atom-dispencer/SolenoidEngine4/pcb/SolenoidEngine4.kicad_pcb

## KiCad design pcb/SolenoidEngine4.kicad_pcb (2026-08-16)

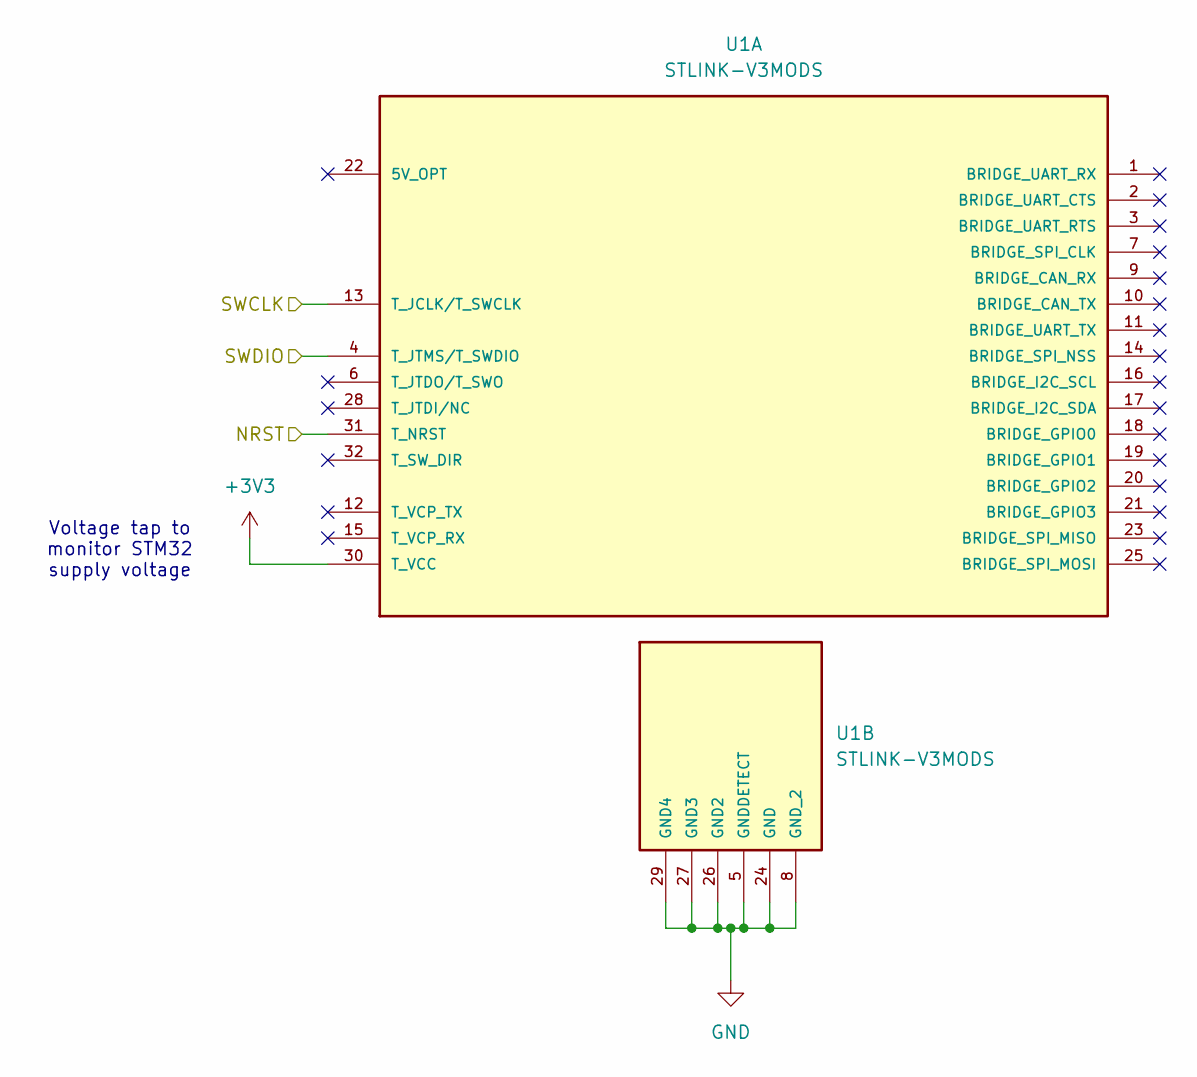
[picture p1: schematic programmer.kicad_sch]

Parts:
U1: STLINK-V3MODS; STLINK_V3MODS; PARTREV 1

Connections:
+3V3: U1.30 (T_VCC); also elsewhere on the board
/Microcontroller/NRST: U1.31 (T_NRST); also elsewhere on the board
/Microcontroller/SWCLK: U1.13 (T_JCLK/T_SWCLK); also elsewhere on the board
/Microcontroller/SWDIO: U1.4 (T_JTMS/T_SWDIO); also elsewhere on the board
GND: U1.5 (GNDDETECT), U1.8 (GND_2), U1.24 (GND), U1.26 (GND2), U1.27 (GND3), U1.29 (GND4); also elsewhere on the board

Notes on the sheet:
Voltage tap to monitor STM32 supply voltage

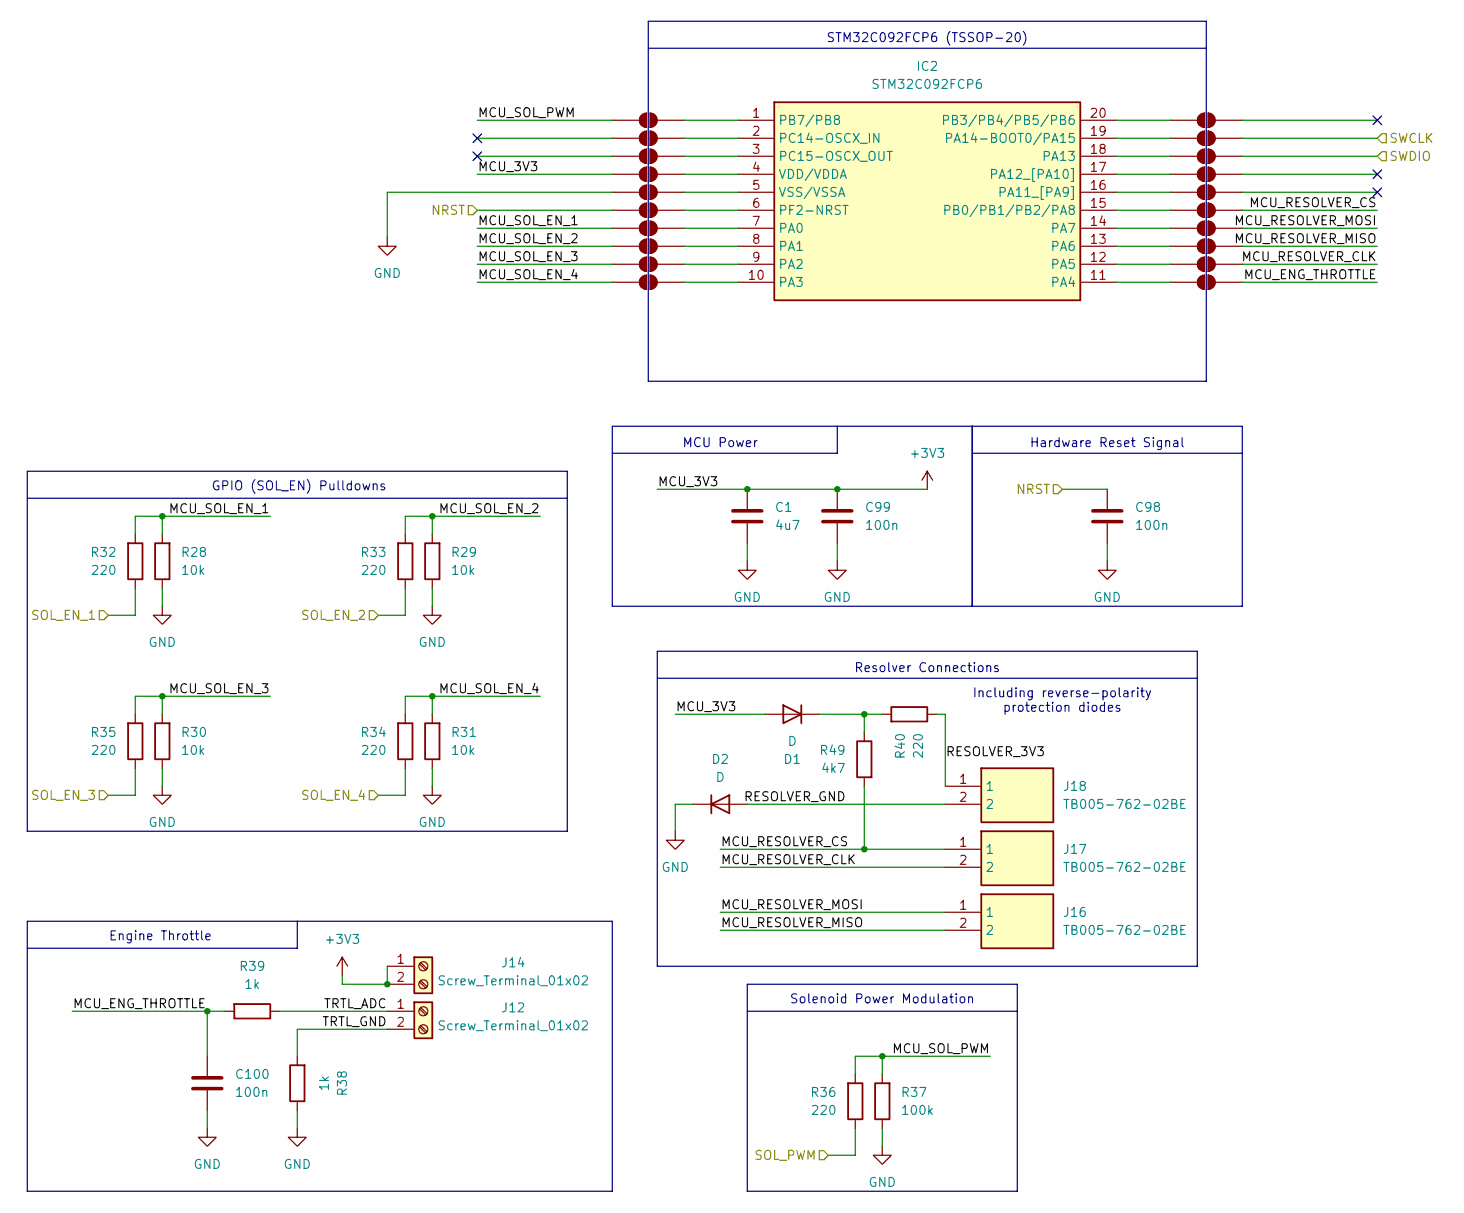
[picture p2: schematic microcontroller.kicad_sch]

Parts:
C1: 4u7; C_0805_2012Metric
C98: 100n; C_0603_1608Metric
C99, C100: 100n; C_0805_2012Metric
D1, D2: D; D_0805_2012Metric
IC2: STM32C092FCP6; SOP65P640X120-20N; Manufacturer_Part_Number STM32C092FCP6
J12, J14: Screw_Terminal_01x02; TB005-762-02BE
J16, J17, J18: TB005-762-02BE; Mouser Part Number 490-TB005-762-02BE
JP1, JP2, JP3, JP4, JP5, JP6, JP7, JP8, JP9, JP10, JP11, JP12, JP13, JP14, JP15, JP16, JP17, JP18, JP19, JP20: SolderJumper_2_Open; SolderJumper-2_P1.3mm_Open_TrianglePad1.0x1.5mm
R28, R29, R30, R31: 10k; R_0805_2012Metric
R32, R33, R34, R35, R36, R40: 220; R_0805_2012Metric
R37: 100k; R_0805_2012Metric
R38, R39: 1k; R_0805_2012Metric
R49: 4k7; R_0805_2012Metric

Connections:
+3V3: C1.1, C99.1, D1.2 (A), J14.1, J14.2, JP14.1 (A); also elsewhere on the board
/Microcontroller/MCU_ENG_THROTTLE: C100.1, JP10.2 (B), R39.2
/Microcontroller/MCU_RESOLVER_CLK: J17.2, JP9.2 (B)
/Microcontroller/MCU_RESOLVER_CS: J17.1, JP6.2 (B), R49.2
/Microcontroller/MCU_RESOLVER_MISO: J16.2, JP8.2 (B)
/Microcontroller/MCU_RESOLVER_MOSI: J16.1, JP7.2 (B)
/Microcontroller/MCU_SOL_EN_1: JP17.1 (A), R28.2, R32.2
/Microcontroller/MCU_SOL_EN_2: JP18.1 (A), R29.2, R33.2
/Microcontroller/MCU_SOL_EN_3: JP19.1 (A), R30.2, R35.2
/Microcontroller/MCU_SOL_EN_4: JP20.1 (A), R31.2, R34.2
/Microcontroller/MCU_SOL_PWM: JP11.1 (A), R36.2, R37.2
/Microcontroller/NRST: C98.1, JP16.1 (A); also elsewhere on the board
/Microcontroller/RESOLVER_3V3: J18.1, R40.1
/Microcontroller/RESOLVER_GND: D2.2 (A), J18.2
/Microcontroller/SOL_EN_1: R32.1; also elsewhere on the board
/Microcontroller/SOL_EN_2: R33.1; also elsewhere on the board
/Microcontroller/SOL_EN_3: R35.1; also elsewhere on the board
/Microcontroller/SOL_EN_4: R34.1; also elsewhere on the board
/Microcontroller/SOL_PWM: R36.1; also elsewhere on the board
/Microcontroller/SWCLK: JP2.2 (B); also elsewhere on the board
/Microcontroller/SWDIO: JP3.2 (B); also elsewhere on the board
/Microcontroller/TRTL_ADC: J12.1, R39.1
/Microcontroller/TRTL_GND: J12.2, R38.2
GND: C1.2, C98.2, C99.2, C100.2, D2.1 (K), JP15.1 (A), R28.1, R29.1, R30.1, R31.1, R37.1, R38.1; also elsewhere on the board
unnamed: D1.1 (K), R40.2, R49.1
unnamed: IC2.7 (PA0), JP17.2 (B)
unnamed: IC2.8 (PA1), JP18.2 (B)
unnamed: IC2.9 (PA2), JP19.2 (B)
unnamed: IC2.10 (PA3), JP20.2 (B)
unnamed: IC2.11 (PA4), JP10.1 (A)
unnamed: IC2.12 (PA5), JP9.1 (A)
unnamed: IC2.13 (PA6), JP8.1 (A)
unnamed: IC2.14 (PA7), JP7.1 (A)
unnamed: IC2.16 (PA11_[PA9]), JP5.1 (A_1)
unnamed: IC2.17 (PA12_[PA10]), JP4.1 (A_1)
unnamed: IC2.18 (PA13), JP3.1 (A)
unnamed: IC2.19 (PA14-BOOT0/PA15), JP2.1 (A)
unnamed: IC2.15 (PB0/PB1/PB2/PA8), JP6.1 (A)
unnamed: IC2.20 (PB3/PB4/PB5/PB6), JP1.1 (A_1)
unnamed: IC2.1 (PB7/PB8), JP11.2 (B)
unnamed: IC2.2 (PC14-OSCX_IN), JP12.2 (B_2)
unnamed: IC2.3 (PC15-OSCX_OUT), JP13.2 (B_2)
unnamed: IC2.6 (PF2-NRST), JP16.2 (B)
unnamed: IC2.4 (VDD/VDDA), JP14.2 (B)
unnamed: IC2.5 (VSS/VSSA), JP15.2 (B)

Notes on the sheet:
Solenoid Power Modulation
STM32C092FCP6 (TSSOP-20)
Hardware Reset Signal
Including reverse-polarity protection diodes
Engine Throttle
MCU Power
GPIO (SOL_EN) Pulldowns
Resolver Connections

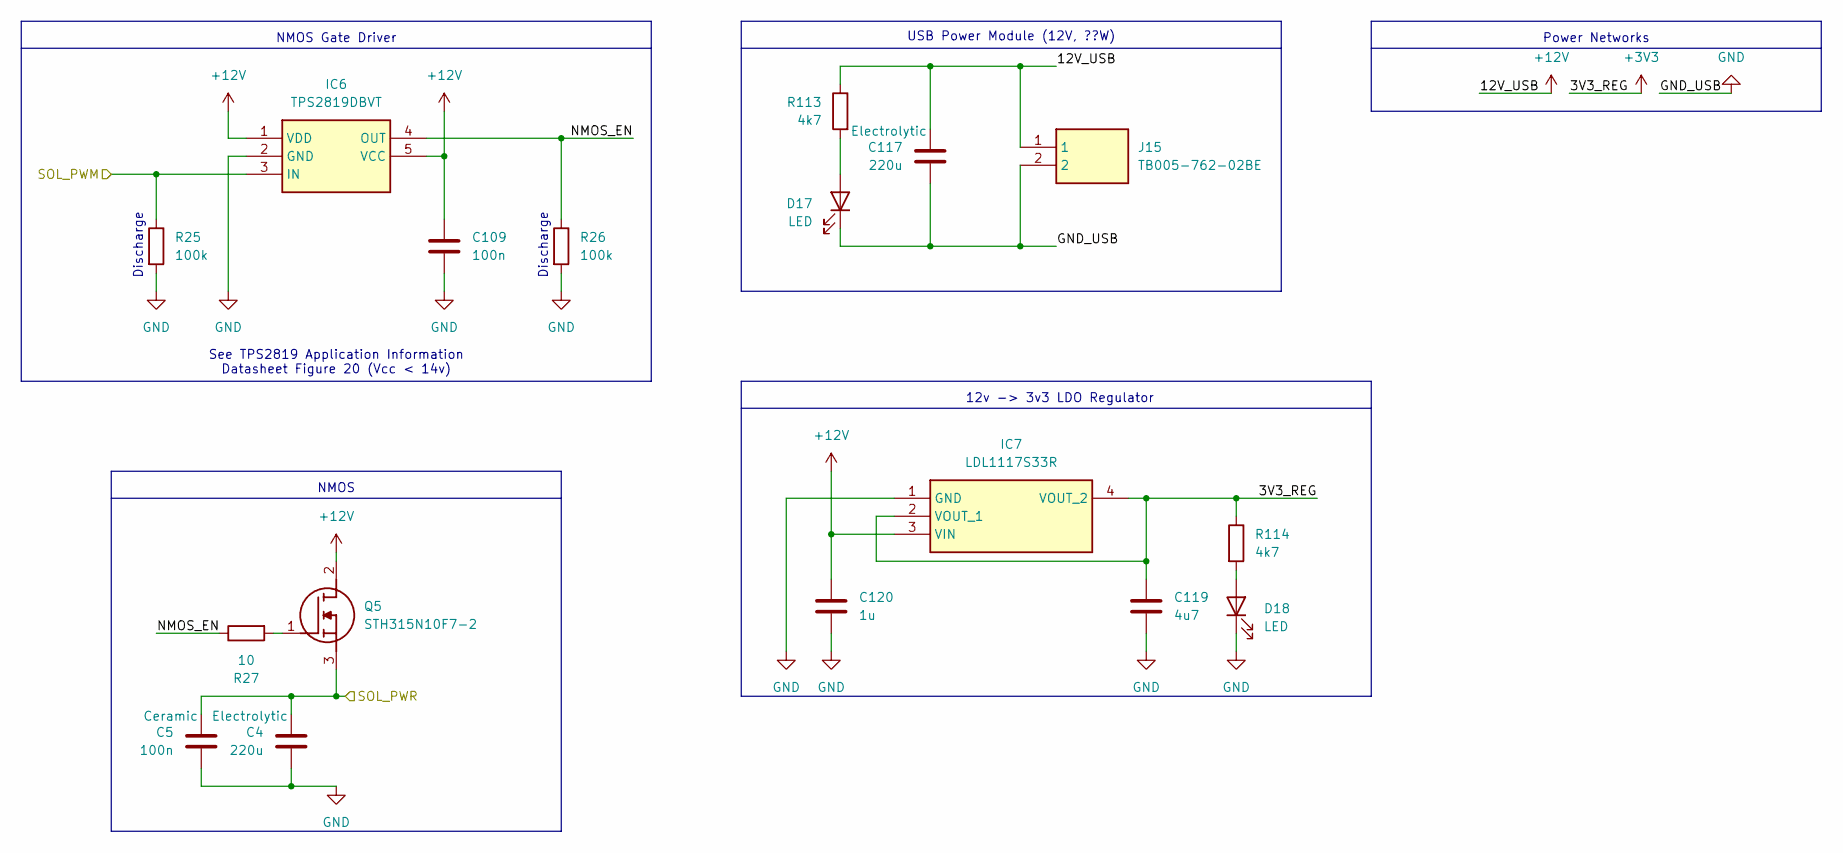
[picture p3: schematic power.kicad_sch]

Parts:
C4, C117: 220u; CP_Elec_10x10
C5, C109: 100n; C_0805_2012Metric
C119: 4u7; C_0805_2012Metric
C120: 1u; C_0805_2012Metric
D17, D18: LED; D_0805_2012Metric
IC6: TPS2819DBVT; SOT95P280X145-5N; Mouser Part Number 595-TPS2819DBVT
IC7: LDL1117S33R; SOT230P700X180-4N; Mouser Part Number 511-LDL1117S33R
J15: TB005-762-02BE; Mouser Part Number 490-TB005-762-02BE
Q5: STH315N10F7-2; STH315N10F72; Mouser Part Number 511-STH315N10F7-2
R25, R26: 100k; R_0805_2012Metric
R27: 10; R_0805_2012Metric
R113, R114: 4k7; R_0805_2012Metric

Connections:
+3V3: C119.1, IC7.2 (VOUT_1), IC7.4 (VOUT_2), R114.1; also elsewhere on the board
+12V: C109.1, C117.1, C120.1, IC6.1 (VDD), IC6.5 (VCC), IC7.3 (VIN), J15.1, Q5.2 (D), R113.1; also elsewhere on the board
/Microcontroller/SOL_PWM: IC6.3 (IN), R25.1; also elsewhere on the board
/Power/NMOS_EN: IC6.4 (OUT), R26.1, R27.1
/Solenoids/Solenoid 1/SOL+: C4.1, C5.1, Q5.3 (S); also elsewhere on the board
GND: C4.2, C5.2, C109.2, C117.2, C119.2, C120.2, D17.1 (K), D18.1 (K), IC6.2 (GND), IC7.1 (GND), J15.2, R25.2, R26.2; also elsewhere on the board
unnamed: D17.2 (A), R113.2
unnamed: D18.2 (A), R114.2
unnamed: Q5.1 (G), R27.2

Notes on the sheet:
Power Networks
USB Power Module (12V, ??W)
12v -> 3v3 LDO Regulator
See TPS2819 Application Information Datasheet Figure 20 (Vcc < 14v)
Discharge
NMOS
NMOS Gate Driver

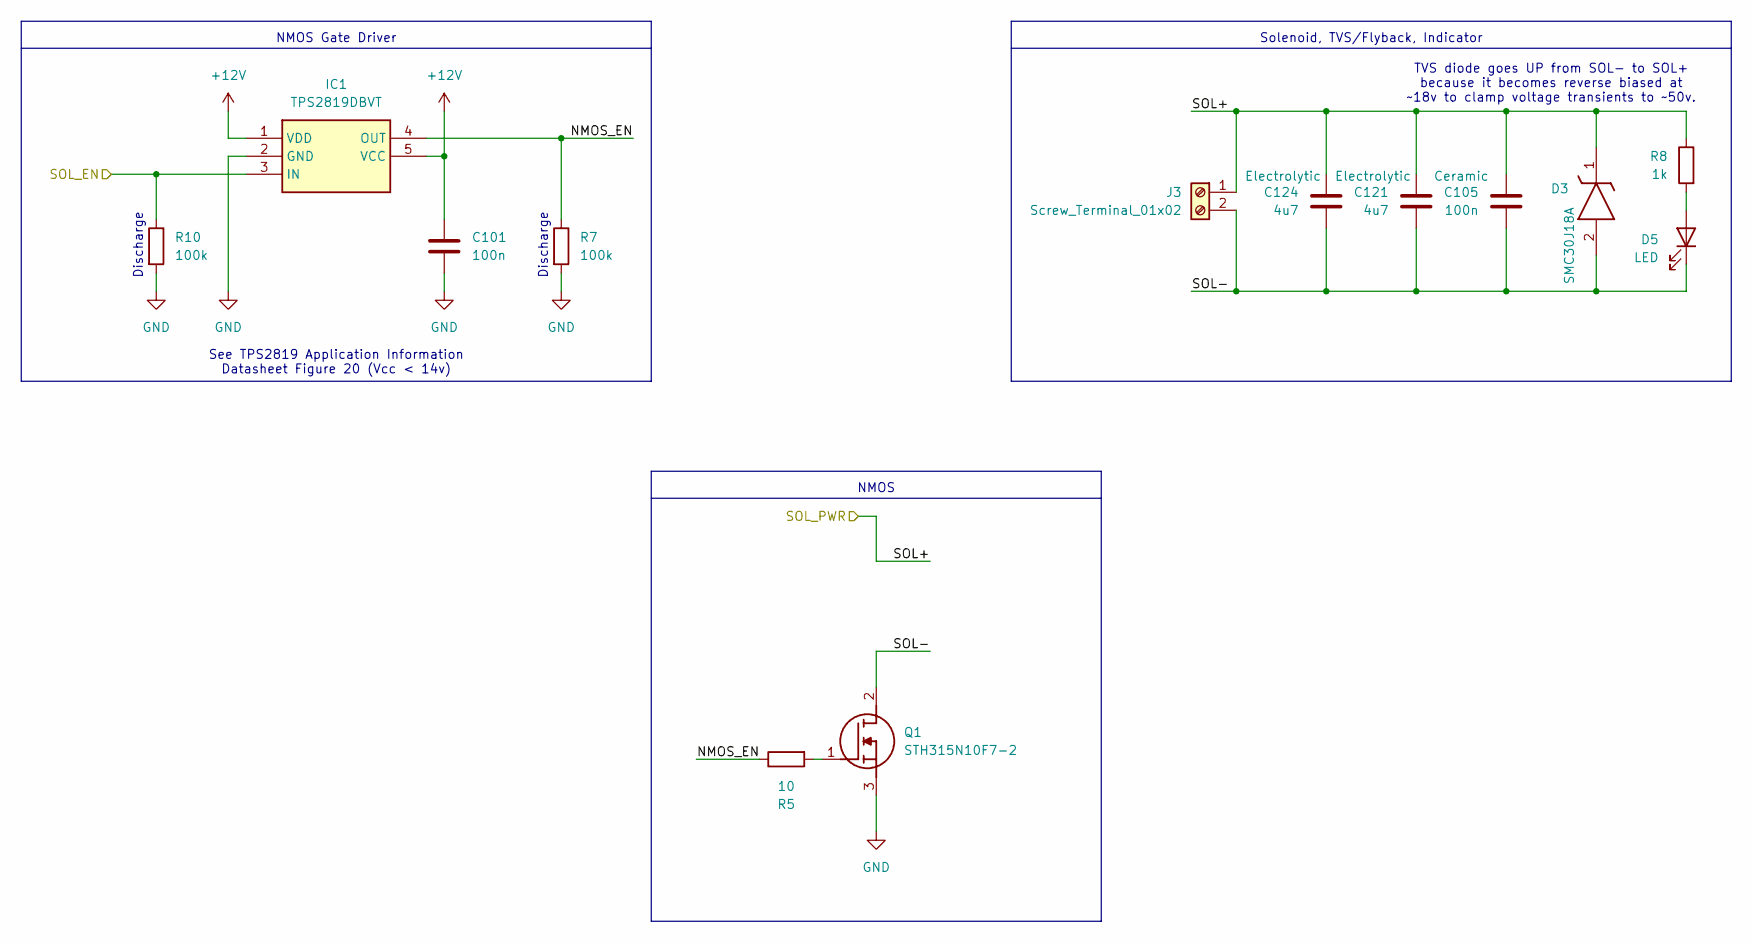
[picture p4: schematic solenoid_1.kicad_sch]

Parts:
C101, C105: 100n; C_0805_2012Metric
C121, C124: 4u7; C_0805_2012Metric
D3: SMC30J18A; DIOM8059X265N; Manufacturer_Part_Number SMC30J18A
D5: LED; D_0805_2012Metric
IC1: TPS2819DBVT; SOT95P280X145-5N; Mouser Part Number 595-TPS2819DBVT
J3: Screw_Terminal_01x02; TB005-762-02BE
Q1: STH315N10F7-2; STH315N10F72; Mouser Part Number 511-STH315N10F7-2
R5: 10; R_0805_2012Metric
R7, R10: 100k; R_0805_2012Metric
R8: 1k; R_0805_2012Metric

Connections:
+12V: C101.1, IC1.1 (VDD), IC1.5 (VCC); also elsewhere on the board
/Microcontroller/SOL_EN_1: IC1.3 (IN), R10.1; also elsewhere on the board
/Solenoids/Solenoid 1/NMOS_EN: IC1.4 (OUT), R5.1, R7.1
/Solenoids/Solenoid 1/SOL+: C105.1, C121.1, C124.1, D3.1 (K), J3.1, R8.1; also elsewhere on the board
/Solenoids/Solenoid 1/SOL-: C105.2, C121.2, C124.2, D3.2 (A), D5.1 (K), J3.2, Q1.2 (D)
GND: C101.2, IC1.2 (GND), Q1.3 (S), R7.2, R10.2; also elsewhere on the board
unnamed: D5.2 (A), R8.2
unnamed: Q1.1 (G), R5.2

Parts of its further copies:
C102, C103, C104, C106, C107, C108: 100n; C_0805_2012Metric
C122, C123, C125, C126, C127, C128: 4u7; C_0805_2012Metric
D4, D6, D8: SMC30J18A; DIOM8059X265N; Manufacturer_Part_Number SMC30J18A
D7, D9, D11: LED; D_0805_2012Metric
IC3, IC4, IC5: TPS2819DBVT; SOT95P280X145-5N; Mouser Part Number 595-TPS2819DBVT
J7, J10, J13: Screw_Terminal_01x02; TB005-762-02BE
Q2, Q3, Q4: STH315N10F7-2; STH315N10F72; Mouser Part Number 511-STH315N10F7-2
R6, R18, R23: 10; R_0805_2012Metric
R12, R13, R16, R17, R21, R22: 100k; R_0805_2012Metric
R14, R19, R24: 1k; R_0805_2012Metric

Connections of its further copies:
+12V: C102.1, C103.1, C104.1, IC3.1 (VDD), IC3.5 (VCC), IC4.1 (VDD), IC4.5 (VCC), IC5.1 (VDD), IC5.5 (VCC); also elsewhere on the board
/Microcontroller/SOL_EN_2: IC3.3 (IN), R12.1; also elsewhere on the board
/Microcontroller/SOL_EN_3: IC4.3 (IN), R16.1; also elsewhere on the board
/Microcontroller/SOL_EN_4: IC5.3 (IN), R21.1; also elsewhere on the board
/Solenoids/Solenoid 1/SOL+: C106.1, C107.1, C108.1, C122.1, C123.1, C125.1, C126.1, C127.1, C128.1, D4.1 (K), D6.1 (K), D8.1 (K), J7.1, J10.1, J13.1, R14.1, R19.1, R24.1; also elsewhere on the board
/Solenoids/Solenoid 2/NMOS_EN: IC3.4 (OUT), R6.1, R13.1
/Solenoids/Solenoid 2/SOL-: C106.2, C122.2, C125.2, D4.2 (A), D7.1 (K), J7.2, Q2.2 (D)
/Solenoids/Solenoid 3/NMOS_EN: IC4.4 (OUT), R17.1, R18.1
/Solenoids/Solenoid 3/SOL-: C107.2, C123.2, C126.2, D6.2 (A), D9.1 (K), J10.2, Q3.2 (D)
/Solenoids/Solenoid 4/NMOS_EN: IC5.4 (OUT), R22.1, R23.1
/Solenoids/Solenoid 4/SOL-: C108.2, C127.2, C128.2, D8.2 (A), D11.1 (K), J13.2, Q4.2 (D)
GND: C102.2, C103.2, C104.2, IC3.2 (GND), IC4.2 (GND), IC5.2 (GND), Q2.3 (S), Q3.3 (S), Q4.3 (S), R12.2, R13.2, R16.2, R17.2, R21.2, R22.2; also elsewhere on the board
unnamed: D7.2 (A), R14.2
unnamed: D9.2 (A), R19.2
unnamed: D11.2 (A), R24.2
unnamed: Q2.1 (G), R6.2
unnamed: Q3.1 (G), R18.2
unnamed: Q4.1 (G), R23.2

Notes on the sheet:
Discharge
TVS diode goes UP from SOL- to SOL+ because it becomes reverse biased at ~18v to clamp voltage transients to ~50v.
NMOS Gate Driver
Solenoid, TVS/Flyback, Indicator
NMOS
See TPS2819 Application Information Datasheet Figure 20 (Vcc < 14v)

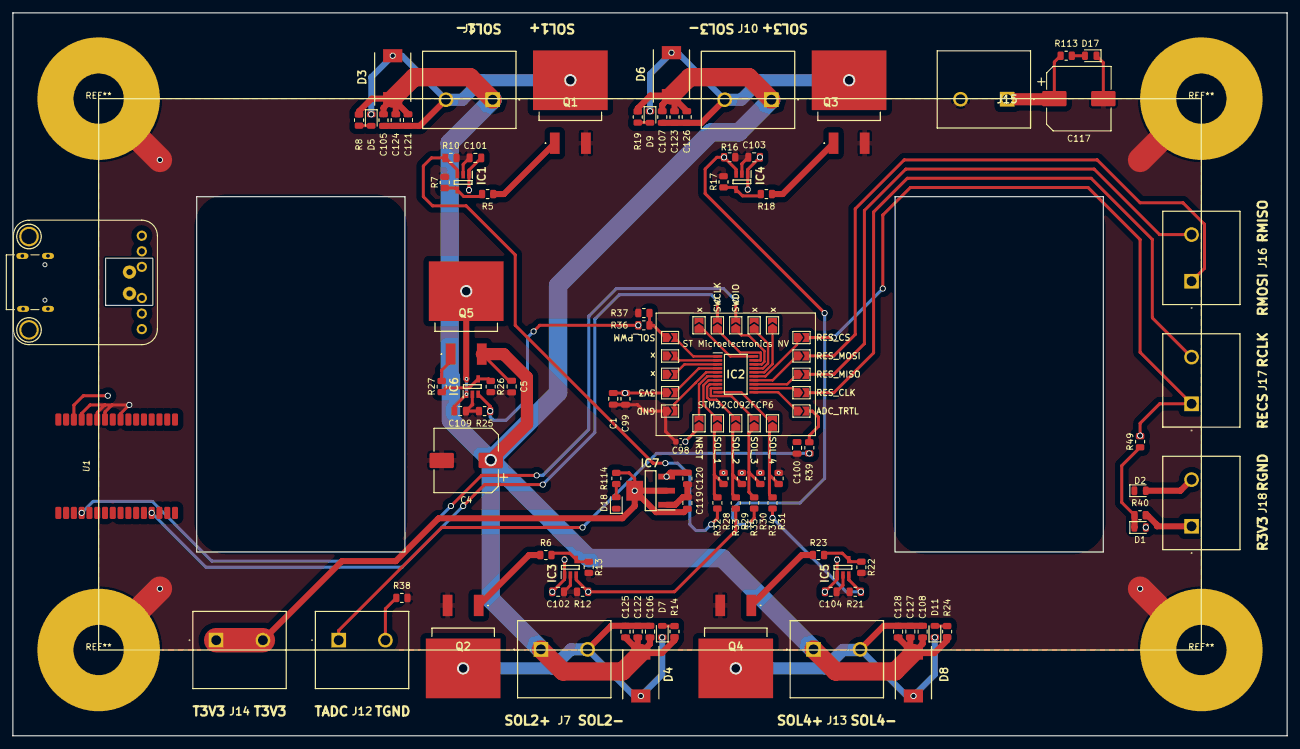
[picture p5: board SolenoidEngine4.kicad_pcb from above]

Board: 4 copper layers, 208.0 x 118.0 mm, 116 parts (0 on the bottom side), 67 nets.
