atom-dispencer/SolenoidEngine4/stm32/SolenoidEngine4.ioc

Mcu.UserName=STM32C092FCPx
PA0.GPIO_Label=SOL_EN_1
PA0.Signal=GPIO_Output
PA1.GPIO_Label=SOL_EN_2
PA1.Signal=GPIO_Output
PA13.Signal=DEBUG_SWDIO
PA14-BOOT0.Signal=DEBUG_SWCLK
PA2.GPIO_Label=SOL_EN_3
PA2.Signal=GPIO_Output
PA3.GPIO_Label=SOL_EN_4
PA3.Signal=GPIO_Output
PA4.GPIO_Label=ENG_THROTTLE
PA4.Signal=ADC1_IN4
PA5.Signal=SPI1_SCK
PA6.Signal=SPI1_MISO
PA7.Signal=SPI1_MOSI
PB0.Signal=SPI1_NSS
PB7.GPIO_Label=SOL_PWM
PB7.Signal=S_TIM16_CH1
