atom-dispencer/SolenoidEngine4/stm32/Core/Inc/main.h

#define SOL_PWM_Pin GPIO_PIN_7
#define SOL_PWM_GPIO_Port GPIOB
#define SOL_EN_1_Pin GPIO_PIN_0
#define SOL_EN_1_GPIO_Port GPIOA
#define SOL_EN_2_Pin GPIO_PIN_1
#define SOL_EN_2_GPIO_Port GPIOA
#define SOL_EN_3_Pin GPIO_PIN_2
#define SOL_EN_3_GPIO_Port GPIOA
#define SOL_EN_4_Pin GPIO_PIN_3
#define SOL_EN_4_GPIO_Port GPIOA
#define ENG_THROTTLE_Pin GPIO_PIN_4
#define ENG_THROTTLE_GPIO_Port GPIOA
