atom-dispencer/SolenoidEngine4/(commit log)

2026-08-01 Create STM32 project, expand ADC and GPIO schematic
    [SolenoidEngine4.kicad_sch, microcontroller.kicad_sch, power.kicad_sch, solenoid_1.kicad_sch, solenoids.kicad_sch]
2026-08-03 More stm32 stuff
2026-08-06 Main PCB nearly done, created resolver PCB, more STM32 work
    [SolenoidEngine4.kicad_sch, SolenoidEngine4_Resolver.kicad_pcb, SolenoidEngine4_Resolver.kicad_sch, microcontroller.kicad_sch, power.kicad_sch, programmer.kicad_sch, solenoid_1.kicad_sch]
2026-08-07 Resolver PCB nearly done
    [SolenoidEngine4_Resolver.kicad_sch]
2026-08-08 Started iteration 4B of CAD today so I have the dimensions of the PCB - have now started layout
    [SolenoidEngine4.kicad_pcb, solenoid_1.kicad_sch]
2026-08-10 Completed all footprints
    [SolenoidEngine4.kicad_pcb, microcontroller.kicad_sch, power.kicad_sch, programmer.kicad_sch, solenoid_1.kicad_sch]
2026-08-10 Grouped all components
    [SolenoidEngine4.kicad_pcb, microcontroller.kicad_sch]
2026-08-14 PCB nearly done
    [SolenoidEngine4.kicad_pcb, microcontroller.kicad_sch, power.kicad_sch, programmer.kicad_sch]
2026-08-14 PCB ready for review
    [SolenoidEngine4.kicad_pcb, power.kicad_sch, solenoid_1.kicad_sch]
2026-08-14 Fixed a couple minor issues, re-ran DRC, added my name :)
    [SolenoidEngine4.kicad_pcb]
2026-08-16 I forgot to put the holes in
    [SolenoidEngine4.kicad_pcb, power.kicad_sch]
2026-08-16 Fix .gitignore
    [SolenoidEngine4.kicad_pcb]
2026-08-18 fmodf fixes (I think) and normalising control input vs. force
    [SolenoidEngine4.c]
